klsbecker/linear-power-supply/documentacao/package.tex

% ESTES SÃO OS PACOTES UTILIZADO NESTE TEXTO, QUALQUER ALTERAÇÃO NA ESTRUTURA DO TEXTO
% É FEITA POR ALGUM DESSES PACOTES, TODOS TEM UMA FUNÇÃO ESPÉRICA. NÃO OS REMOVA, MAS FIQUE A VONTADE PARA ADICIONAR MAIS.

\usepackage[T1]{fontenc}
\usepackage[brazil]{babel}
\usepackage[utf8]{inputenc}
\usepackage{color, ucs}
\usepackage[table, xcdraw, dvipsnames]{xcolor}
\usepackage{subfigure}
\usepackage{booktabs}
\usepackage{graphics, graphicx}
\usepackage[intlimits]{amsmath}
\usepackage{xfrac}
\usepackage{amssymb}
\usepackage{wrapfig}
\usepackage{paralist} 
\usepackage{pgffor}
\usepackage{authblk}
\usepackage[font=singlespacing,format=plain,justification=justified,skip=0pt]{caption}            % Altera o comportamento da tag caption 
\usepackage{indentfirst}
\usepackage{abstract} 
\usepackage{titlesec} 
\usepackage{siunitx}
\usepackage[version=4]{mhchem}
\usepackage{pdfpages}
\usepackage{appendix}
\usepackage{blindtext}
\usepackage{bm}
\usepackage{enumitem}
\usepackage{mdframed}
\usepackage{environ}
\usepackage{mathtools}
\usepackage[hidelinks]{hyperref}
% --------------------
%     REFERENCIAS
%\usepackage{natbib}
\usepackage[alf, abnt-emphasize=bf, recuo=0cm, abnt-etal-cite=2, abnt-etal-list=0, abnt-etal-text=it]{abntex2cite}  % Citações padrão ABNT
\usepackage{quoting}
% --------------------
\usepackage{tikz}
\usepackage{url}
\usepackage{afterpage}
\usepackage{fancybox}
\usepackage{mathptmx}
%\usepackage{lmodern}
%\usepackage{times}
\usepackage{setspace}
\usepackage{multirow}
\usepackage{textcomp}
\usepackage{xparse}
\usepackage{comment}
\usepackage[left=3cm,top=3cm,right=2cm,bottom=2cm]{geometry}

\usepackage{report}
