klsbecker/linear-power-supply/(list of files, drawings)

Other design files:
simulacao/linear-power-supply.ms14
